MillerLabFTW/OpenSourcePneumaticSystem/PicsVids/PneumaticBehaviors.gif

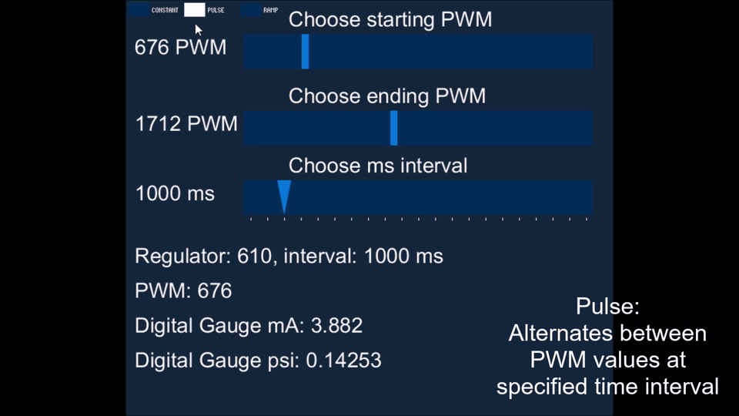
PicsVids/PneumaticBehaviors.gif
