MillerLabFTW/OpenSourcePneumaticSystem/PicsVids/ProcessingGUI_Ramp.gif

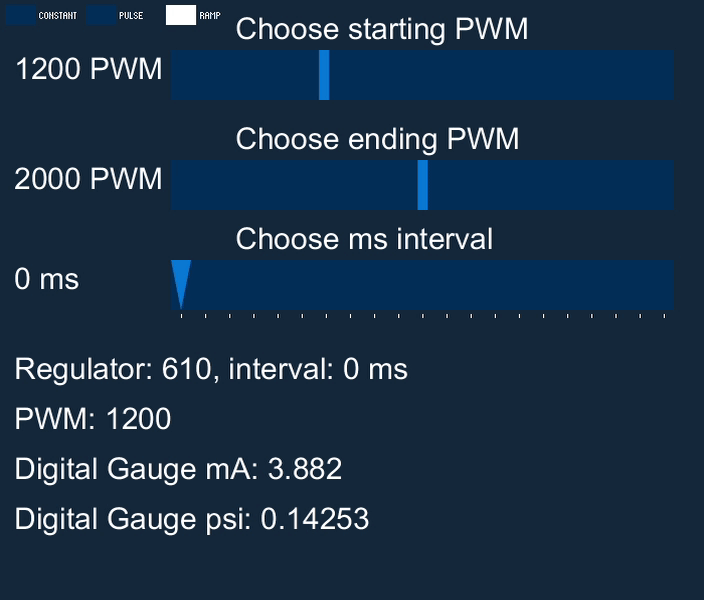
PicsVids/ProcessingGUI_Ramp.gif
