MillerLabFTW/OpenSourcePneumaticSystem/Pneumatic System Bill of Materials.xlsx

MillerLab Pneumatic System Bill of Materials
Item | Vendor | Manufacturer | Part/Model No. | Cost Per Item ($) | Quantity | Total Cost ($) | Notes
Industruino IND.I/O Kit | Industruino.com (https://industruino.com/shop/product/industruino-ind-i-o-kit-2?category=2) | Industruino | 32u4 | $124.43 | 1 | $124.43 | The firmware used is small; we didn't need the Industruino with more memory
Omega Miniature I/P Transducer | Omega.com (http://www.omega.com/pptst/ip610.html) | Omega | IP610-030 | $398.00 | 1 | $398.00 | Note: scroll down on webpage to find correct model no.
LED Wholesalers AC/DC Adapter | Amazon.com (https://www.amazon.com/LEDwholesalers-Power-Adapter-Output-3261-24V/dp/B00E36W0LY) | LED Wholesalers | 3261-24V 609207163480 | $35.00 | 1 | $35.00 | The listed I/P requires at least 24V and Industruino can handle up to 32V
MettleAir Push-to-Connect Round Fittings (Pack of 10) | Amazon.com (https://www.amazon.com/MettleAir-Connect-Straight-Round-Fitting/dp/B00SAOWFY2) | MettleAir | MTCR 1/4-N02 | $16.37 | 1 | $16.37 | Model listed is for 1/4" OD tubing. Choose fittings based on desired tubing diameter
 |  |  |  |  | Total Cost ($) | $573.80
Recommended Items
Ethernet Expansion Module | Industruino.com (https://industruino.com/shop/product/ethernet-expansion-module-10) | Industruino |  | $32.80 | 1 | $32.80 | Optional. Allows connectivity with network servers
VIAIR Inline Pressure Regulator | Amazon.com (https://www.amazon.com/Viair-90150-0-200-Pressure-Regulator/dp/B000YC5IFG) | VIAIR | 90150 | $29.93 | 2 | $59.86 | One used to regulate pressure before I/P transducer. Other used as analog gauge in-line w/ digital gauge
Omega Digital Pressure Gauge | Omega.com (http://www.omega.com/pptst/DPG1000.html) | Omega | DPG1000DAR-30G-1N | $485.00 | 1 | $485.00 | Note: scroll down on webpage to find correct model no.
OnStage Stands Tabletop Rack Stand | Amazon.com (https://www.amazon.com/OnStage-RS7030-Rack-Stand/dp/B000CD1R84) | OnStage | RS7030 | $29.95 | 1 | $29.95 | Used with aluminum DIN rails to vertically mount components
Aluminum DIN Rails | Mouser.com (http://www.mouser.com/ProductDetail/Magnecraft-Schneider-Electric/16-700DIN/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) | Schneider Electric | 528-16-700DIN | $6.69 | 3 | $20.07 | Rails need to be cut in half to fit the rack stand. Number of rails is up to you
 |  |  |  |  | Grand Total ($) | $1201.48
