MillerLabFTW/OpenSourcePneumaticSystem/Pneumatic System Wiring Diagram.pdf

### Ethernet Expansion Module (Optional)

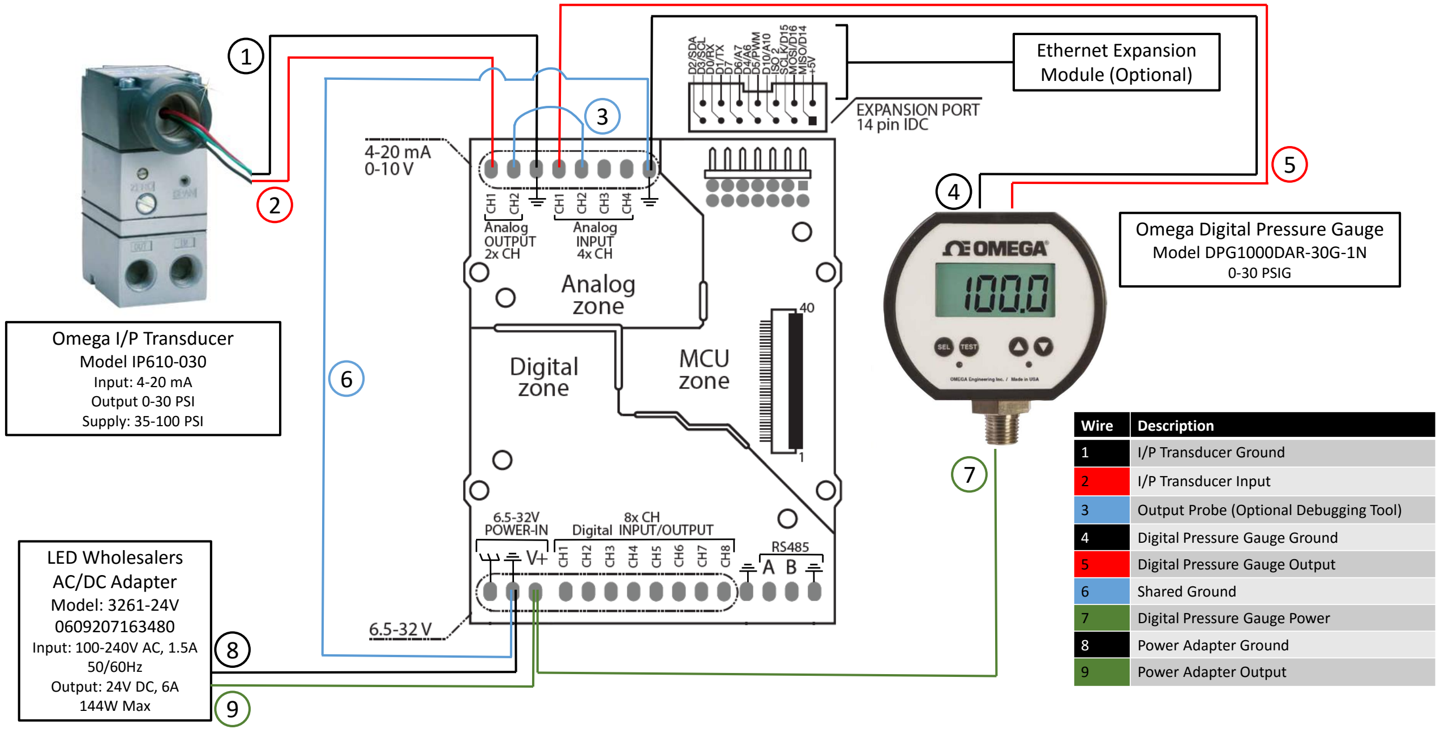
[picture p18: page 1]

### LED Wholesalers AC/DC Adapter

Model: 3261

-24V
0609207163480
Input: 100

-240V AC, 1.5A
50/60Hz
Output: 24V DC, 6A
144W Max

### Omega I/P Transducer

Model IP610

-030
Input: 4

-20 mA
Output 0

-30 PSI
Supply: 35

-100 PSI

### Omega Digital Pressure Gauge

Model DPG1000DAR

-30G

-1N
0

-30 PSIG

Wire | Description 1 | I/P Transducer Ground 2 | I/P Transducer Input 3 | Output Probe (Optional Debugging Tool) 4 | Digital Pressure Gauge Ground 5 | Digital Pressure Gauge Output 6 | Shared Ground 7 | Digital Pressure Gauge Power 8 | Power Adapter Ground 9 | Power Adapter Output

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
