MillerLabFTW/OpenSourcePneumaticSystem/PicsVids/Linux-PneumaticInstall/Add-Indio-master-zip.png

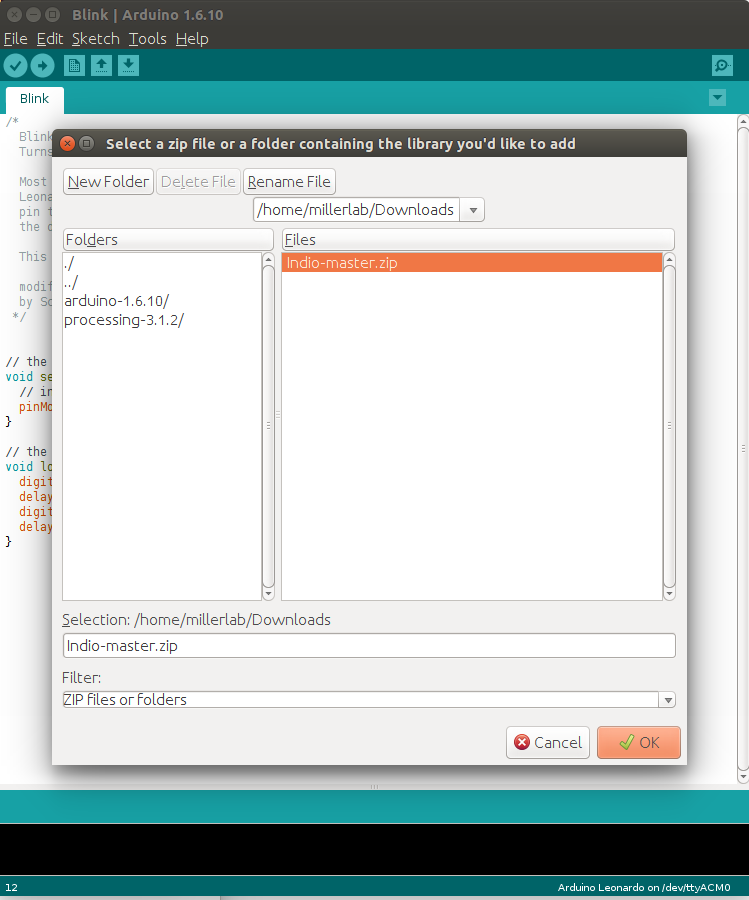
PicsVids/Linux-PneumaticInstall/Add-Indio-master-zip.png
