MillerLabFTW/OpenSourcePneumaticSystem/PicsVids/Linux-PneumaticInstall/Arduino-FirstLaunch.png

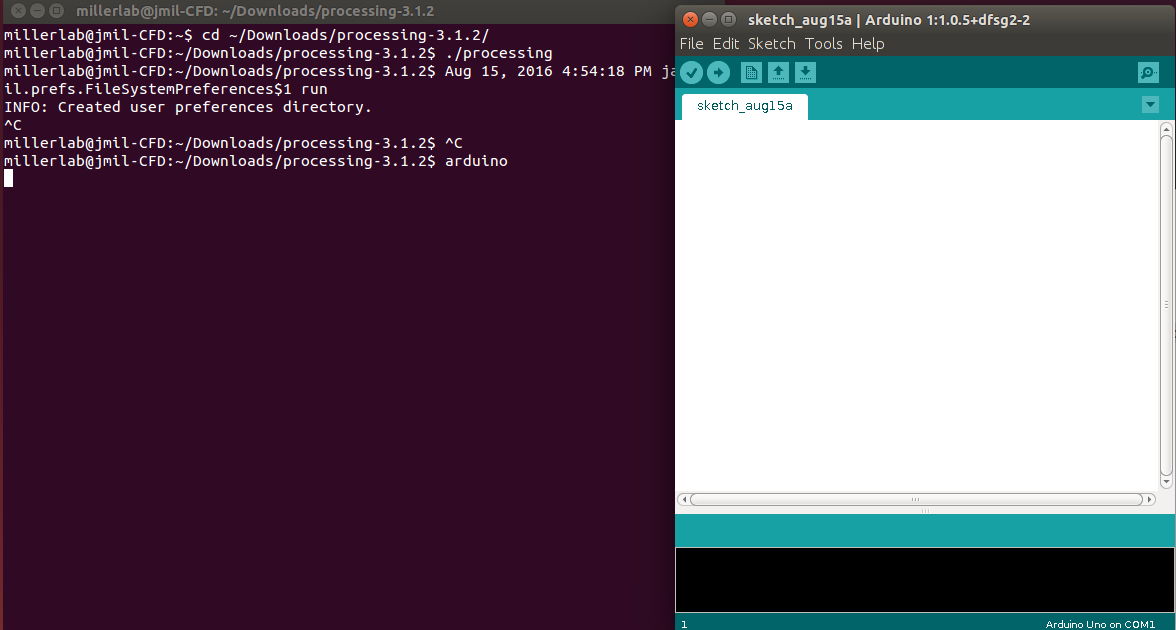
PicsVids/Linux-PneumaticInstall/Arduino-FirstLaunch.png
