MillerLabFTW/OpenSourcePneumaticSystem/PicsVids/Linux-PneumaticInstall/Compiling-Works-Yay.png

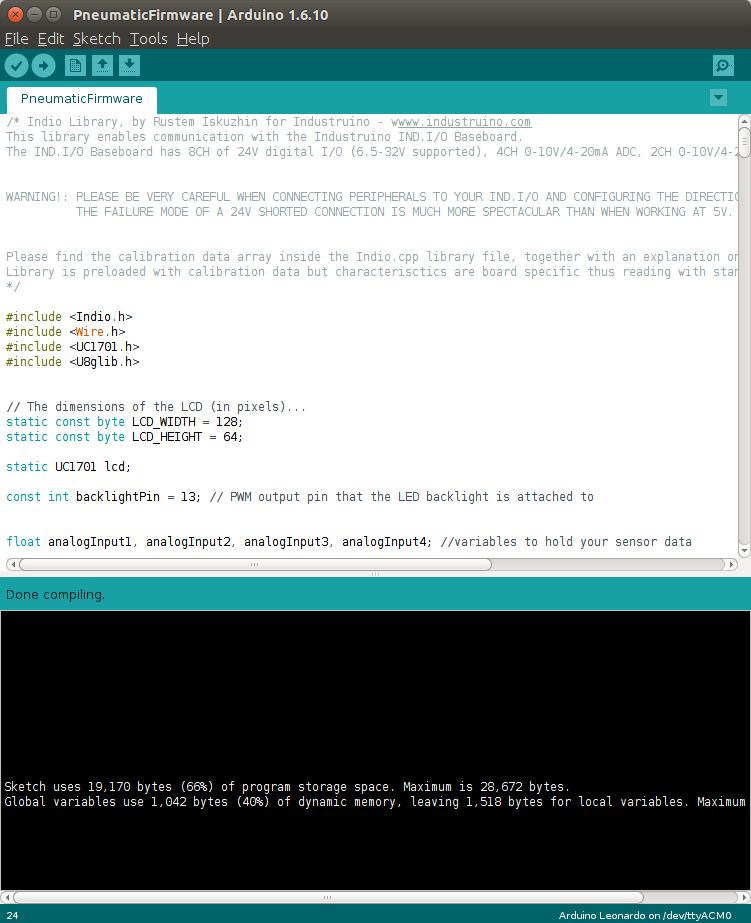
PicsVids/Linux-PneumaticInstall/Compiling-Works-Yay.png
