MillerLabFTW/OpenSourcePneumaticSystem/PicsVids/Linux-PneumaticInstall/ControlP5-missing.png

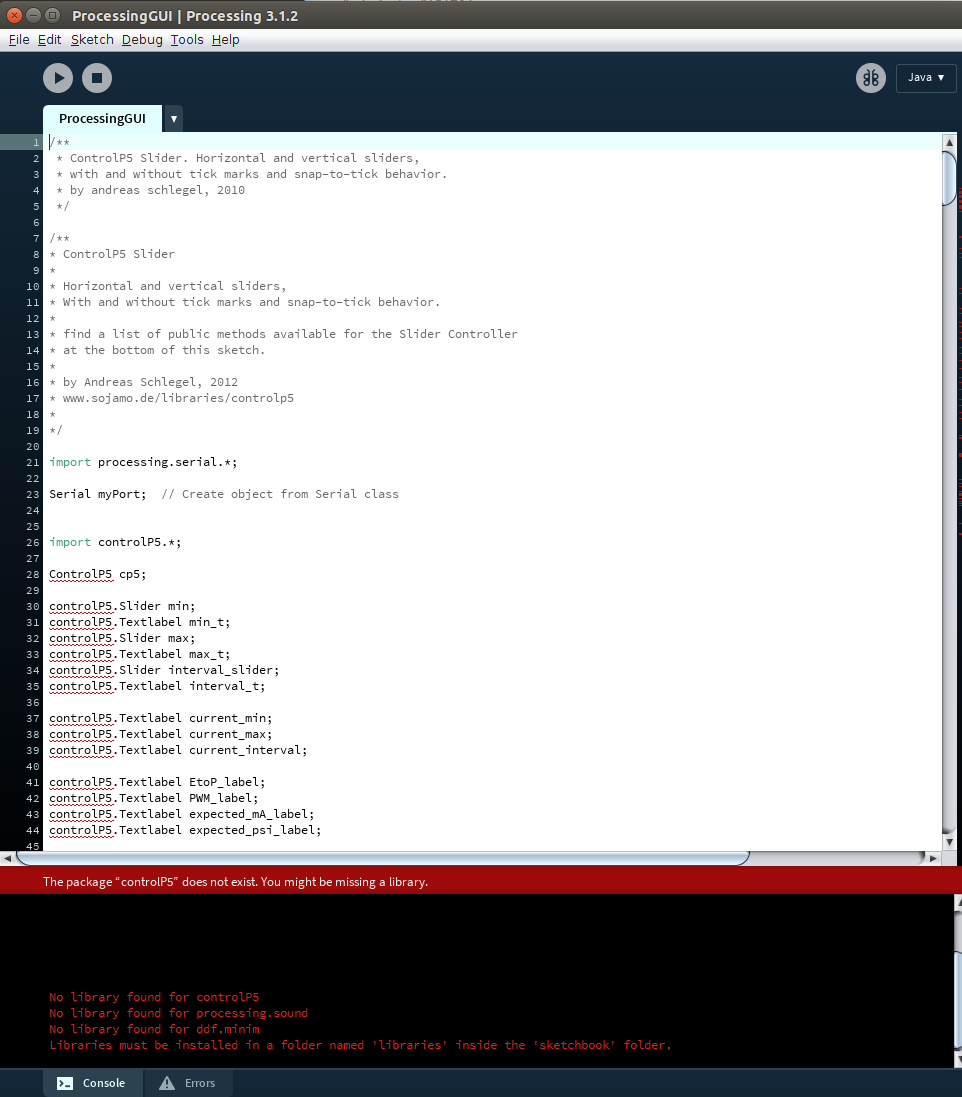
PicsVids/Linux-PneumaticInstall/ControlP5-missing.png
