MillerLabFTW/OpenSourcePneumaticSystem/PicsVids/Linux-PneumaticInstall/Done-Uploading.png

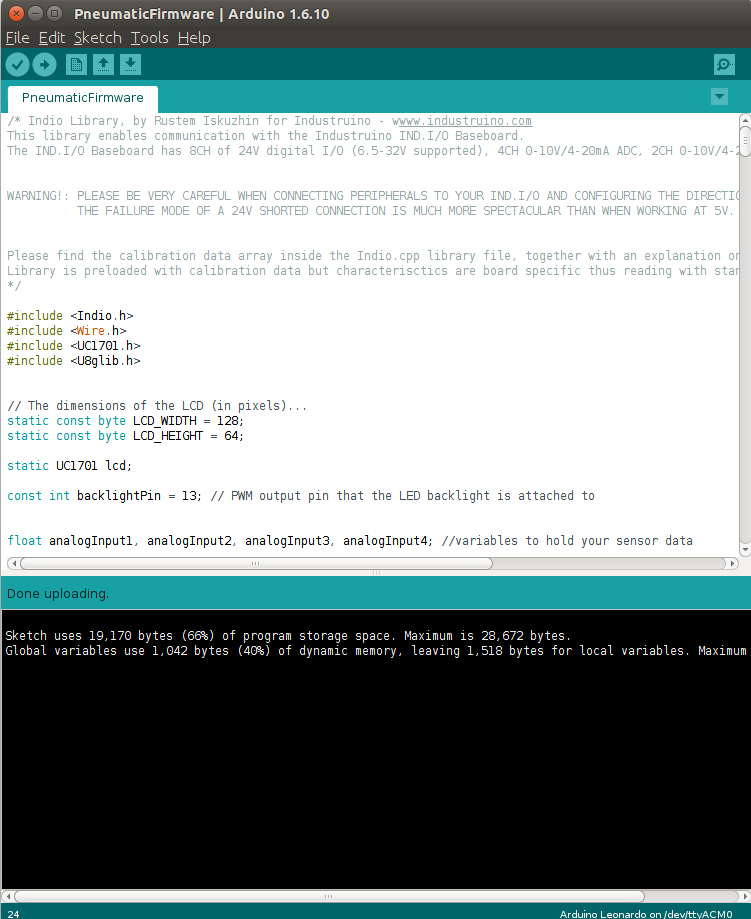
PicsVids/Linux-PneumaticInstall/Done-Uploading.png
