MillerLabFTW/OpenSourcePneumaticSystem/PicsVids/Linux-PneumaticInstall/git clone Industruino.png

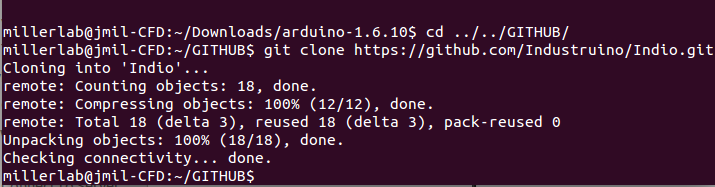
PicsVids/Linux-PneumaticInstall/git clone Industruino.png
