MillerLabFTW/OpenSourcePneumaticSystem/PicsVids/Linux-PneumaticInstall/Indio-Missing-Error.png

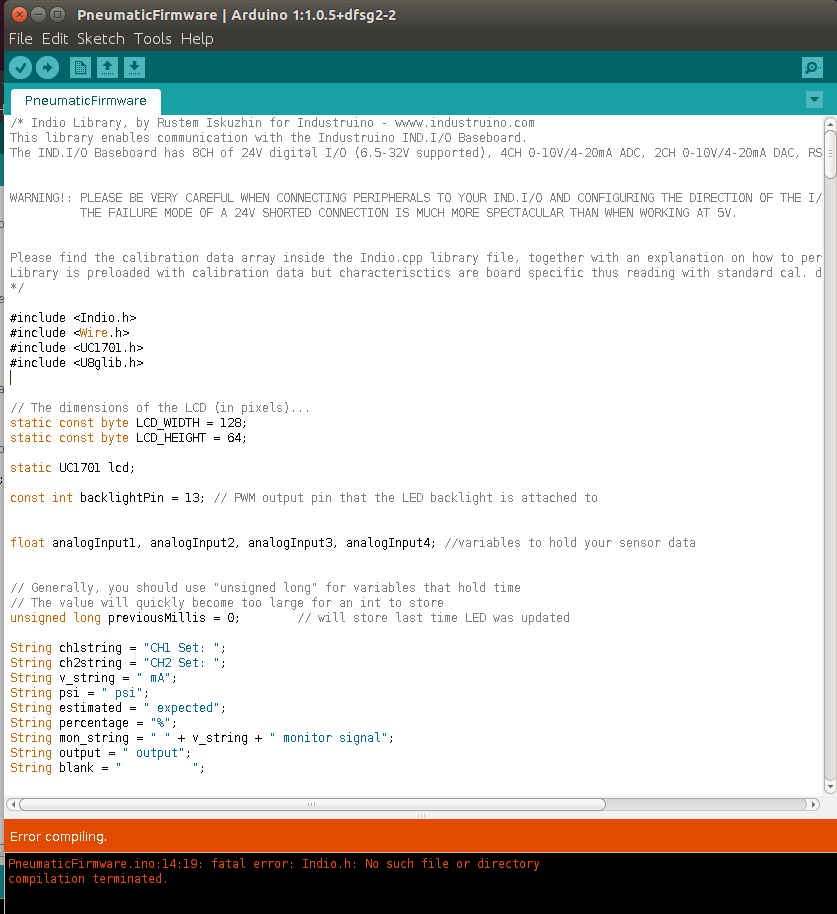
PicsVids/Linux-PneumaticInstall/Indio-Missing-Error.png
