MillerLabFTW/OpenSourcePneumaticSystem/PicsVids/Linux-PneumaticInstall/Install-ControlP5.png

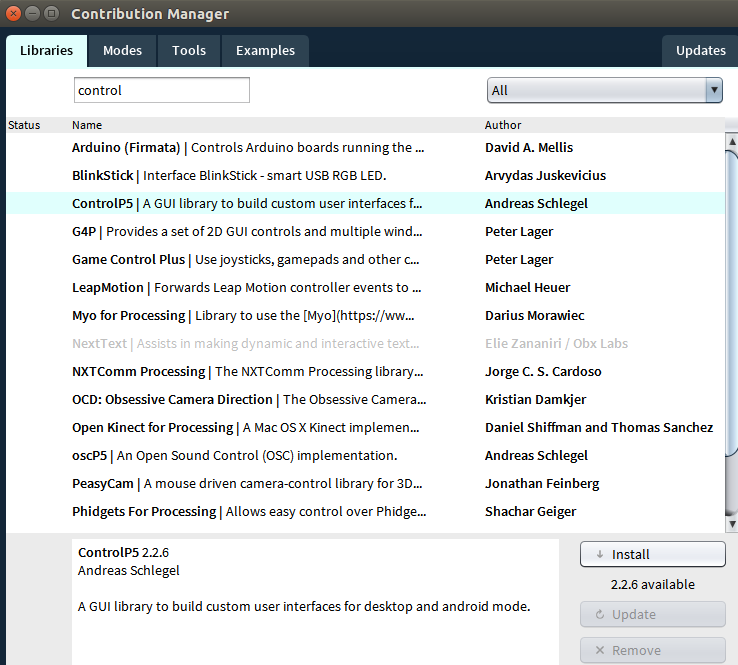
PicsVids/Linux-PneumaticInstall/Install-ControlP5.png
