MillerLabFTW/OpenSourcePneumaticSystem/PicsVids/Linux-PneumaticInstall/Install-Minim.png

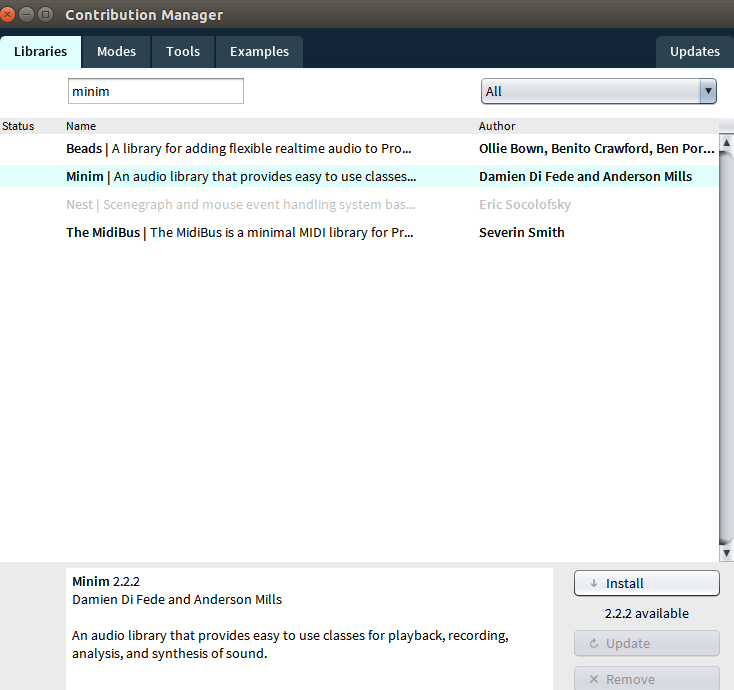
PicsVids/Linux-PneumaticInstall/Install-Minim.png
