MillerLabFTW/OpenSourcePneumaticSystem/PicsVids/Linux-PneumaticInstall/Install-Sound.png

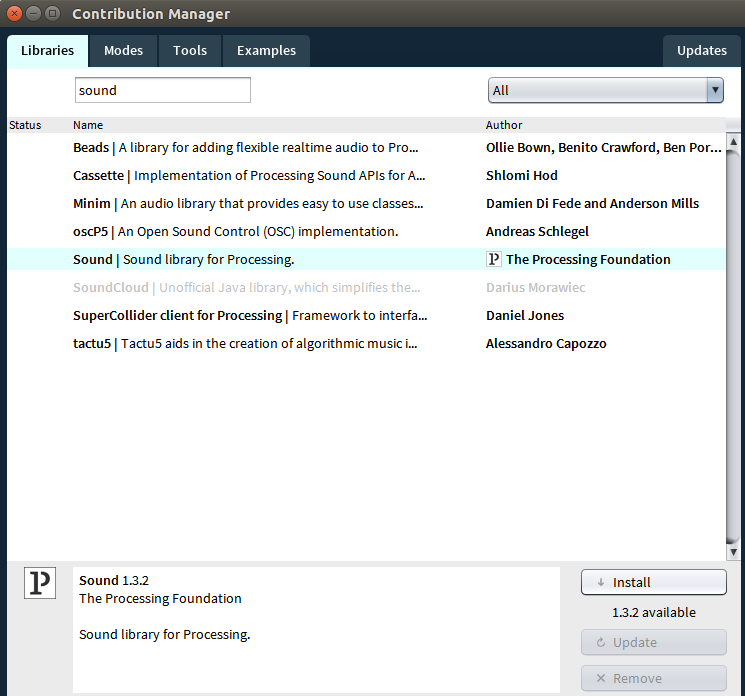
PicsVids/Linux-PneumaticInstall/Install-Sound.png
