MillerLabFTW/OpenSourcePneumaticSystem/PicsVids/Linux-PneumaticInstall/Install-U8glib.png

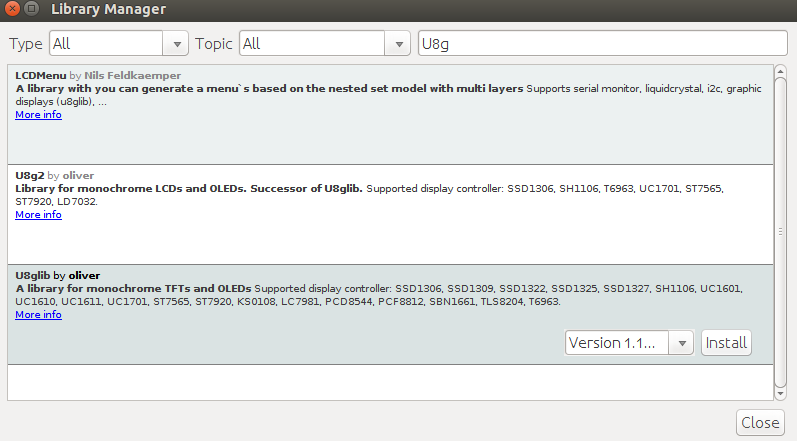
PicsVids/Linux-PneumaticInstall/Install-U8glib.png
