MillerLabFTW/OpenSourcePneumaticSystem/PicsVids/Linux-PneumaticInstall/LibraryAdded.png

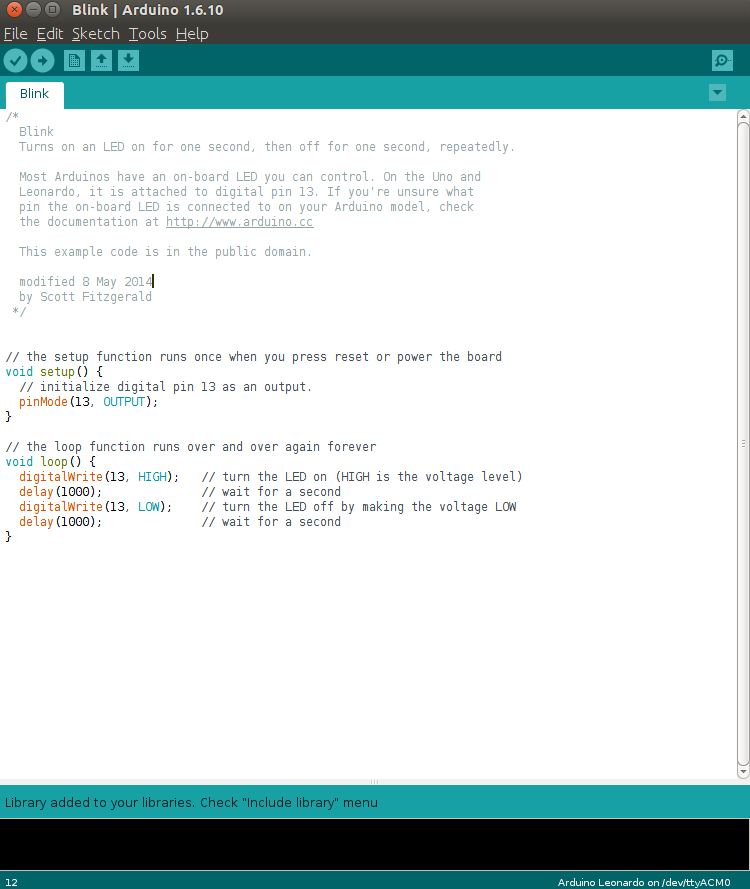
PicsVids/Linux-PneumaticInstall/LibraryAdded.png
