MillerLabFTW/OpenSourcePneumaticSystem/PicsVids/Linux-PneumaticInstall/Processing3-screenshot.png

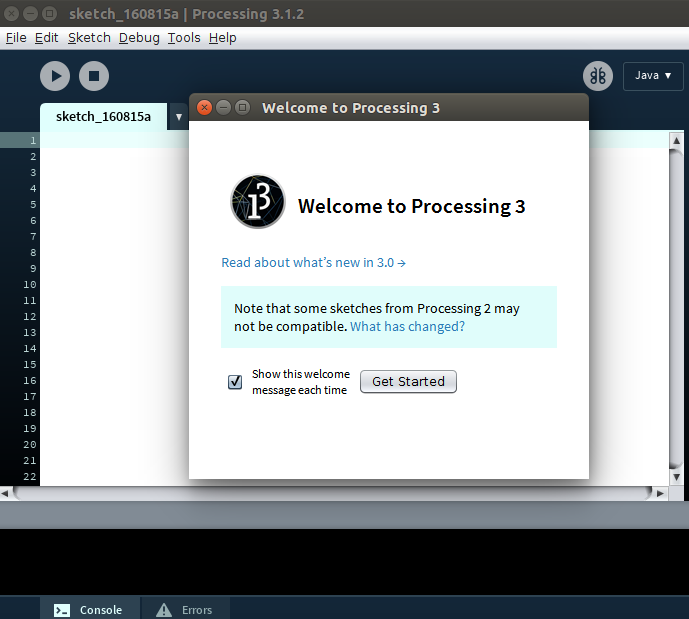
PicsVids/Linux-PneumaticInstall/Processing3-screenshot.png
