MillerLabFTW/OpenSourcePneumaticSystem/PicsVids/Linux-PneumaticInstall/ProcessingGUI-connected.png

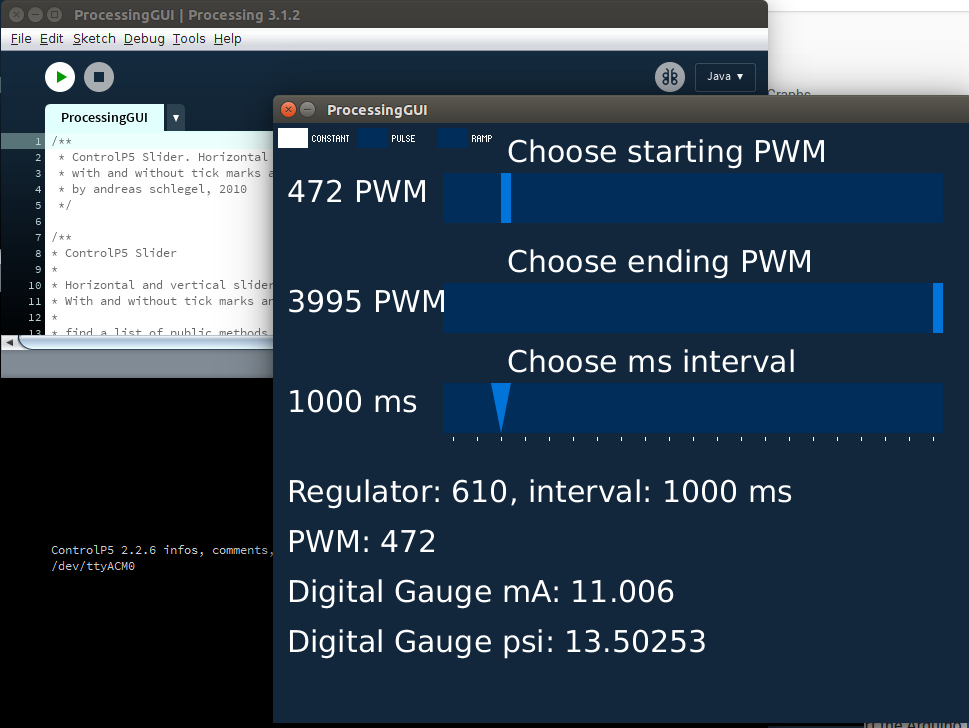
PicsVids/Linux-PneumaticInstall/ProcessingGUI-connected.png
