MillerLabFTW/OpenSourcePneumaticSystem/PicsVids/Linux-PneumaticInstall/UC1701-Library.png

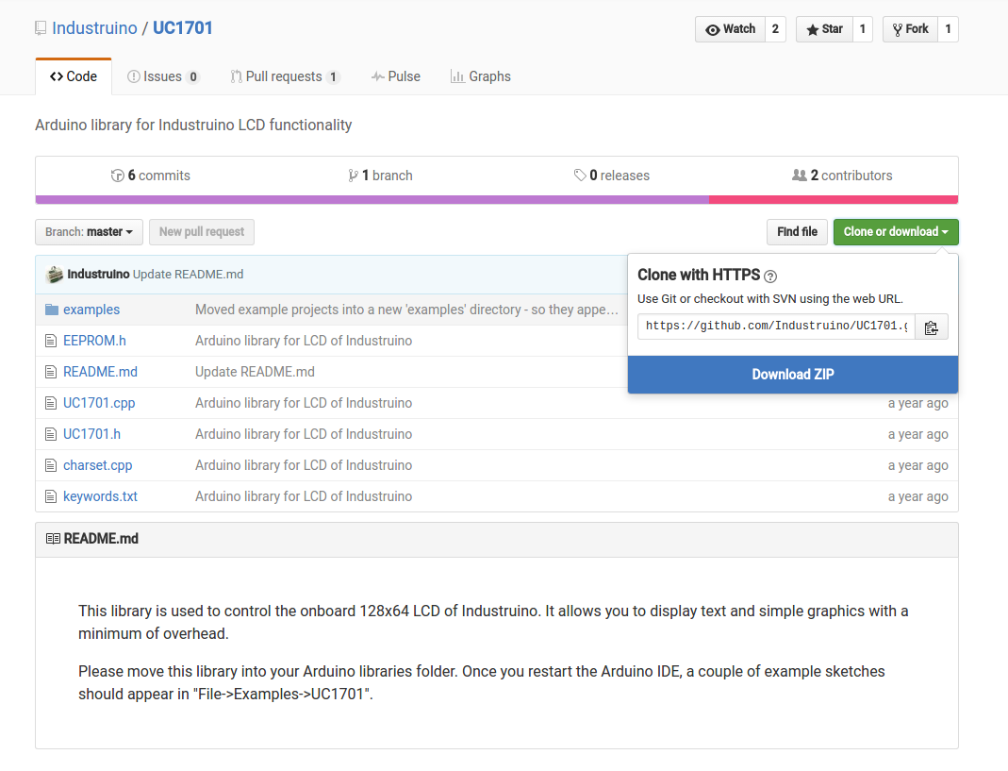
PicsVids/Linux-PneumaticInstall/UC1701-Library.png
