MillerLabFTW/OpenSourcePneumaticSystem/(commit log)

2016-06-24 Updated README and Bill of Materials
    [Pneumatic System Bill of Materials.xlsx]
2016-07-14 Added wiring diagram
2016-07-15 added photo of pneumatic system setup
2016-07-18 Updated Bill of Materials and README
    [Pneumatic System Bill of Materials.xlsx]
2016-07-29 updates to README, Bill of Materials, and remove some debug code from ProcessingGUI
    [Pneumatic System Bill of Materials.xlsx]
2016-08-23 Updated README, removed unneeded library from PneumaticFirmware sketch
2016-08-24 Fixed naming convention for Industruino output (Updated README, ProcessingGUI)
    [ProcessingGUI.pde]
